karunmv/syseng_sensors_lab/arduino/TSP05_Motor_Control/TSP05_Motor_Control.ino

#include "Motors.h"
#include "Sensors.h"
#include "Interface.h"

void setup() {
  Serial.begin(115200);
  setupMotors();
  setupSensors();
  setupInterface();
  Serial.println("READY:ULTRASONIC");
}

void loop() {
  updateButton();
  readSerial();
  updateSensors();
  updateStepper();
  reportStatus();
}
