karunmv/syseng_sensors_lab/dc_control_ir/component_tests/ir_sensor_test/ir_sensor_raw_test.ino

const int IR_PIN = A2;

void setup() {
  Serial.begin(115200);
}

void loop() {
  int raw = analogRead(IR_PIN);
  float voltage = raw * 5.0 / 1023.0;

  Serial.print("Raw ADC: ");
  Serial.print(raw);

  Serial.print(" | Voltage: ");
  Serial.print(voltage, 3);

  Serial.println(" V");

  delay(50);
}
