karunmv/syseng_sensors_lab/(commit log)

2026-11-09 Implement servo and stepper control with sensor integration
2026-11-10 Pot calibration + pot->servo control sketch (servo on D9, calibrated constants)
    [pot_cal.csv]
2026-11-10 Pot/servo README: calibration, error, serial protocol, challenges
2026-11-10 add ToF sensor reading and EWA filtering
2026-11-10 Add basic component tests for dc motor, encoder, and IR sensor
2026-11-11 Add calibrated IR distance measurement test
2026-11-11 added tuned velocity control
2026-11-11 Add IR-based DC motor speed control
2026-11-11 added README for dc motor
2026-11-11 unifying all four sensor-motor code to one file
2026-11-11 add filter plot from aduino ide serial plotter
2026-11-11 Add IR sensor calibration and conversion error analysis
2026-11-11 Document ultrasonic sensor calibration and errors
    Added section on ultrasonic sensor calibration, including error calculations and a distance error table.
